MarcEngrie/BoilerController/Photos/IMG_20221119_143101.jpg

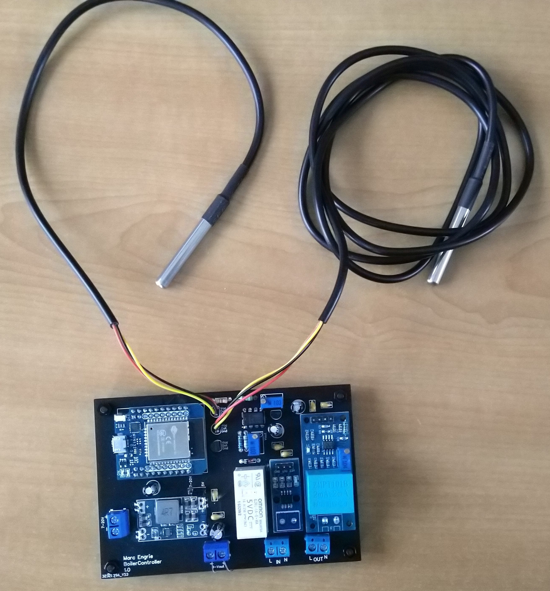
Photos/IMG_20221119_143101.jpg
