MarcEngrie/BoilerController/Photos/IMG_20221120_123733.jpg

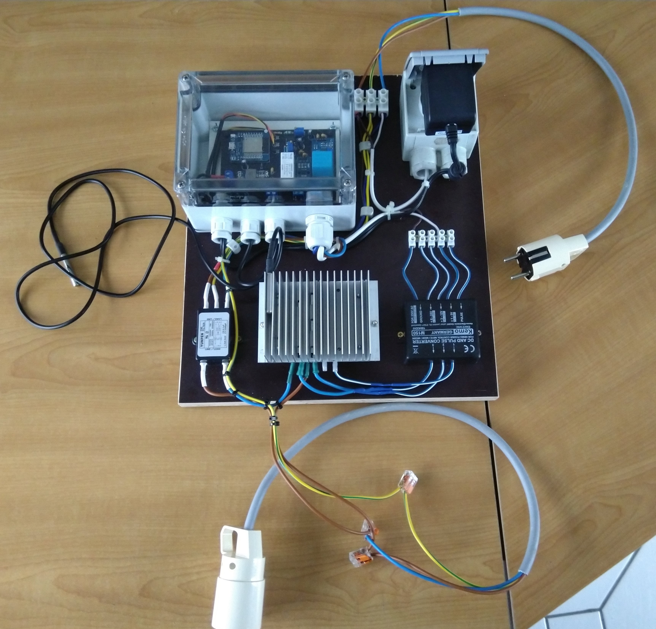
Photos/IMG_20221120_123733.jpg
