MarcEngrie/BoilerController/README.md

# BoilerController
Interface to a hot water boiler and a home automation system using MQTT
