MarcEngrie/BoilerController/EasyEDA/PCB_PCB_BoilerController_2022-11-26.png

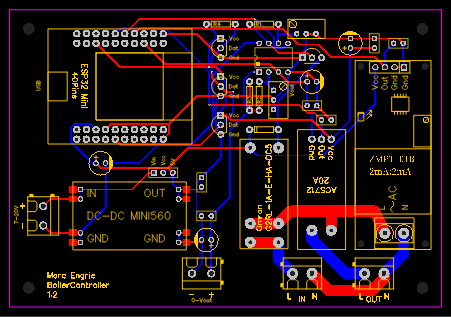
EasyEDA/PCB_PCB_BoilerController_2022-11-26.png
