MarcEngrie/BoilerController/EasyEDA/Schematic_BoilerController_2022-11-26.png

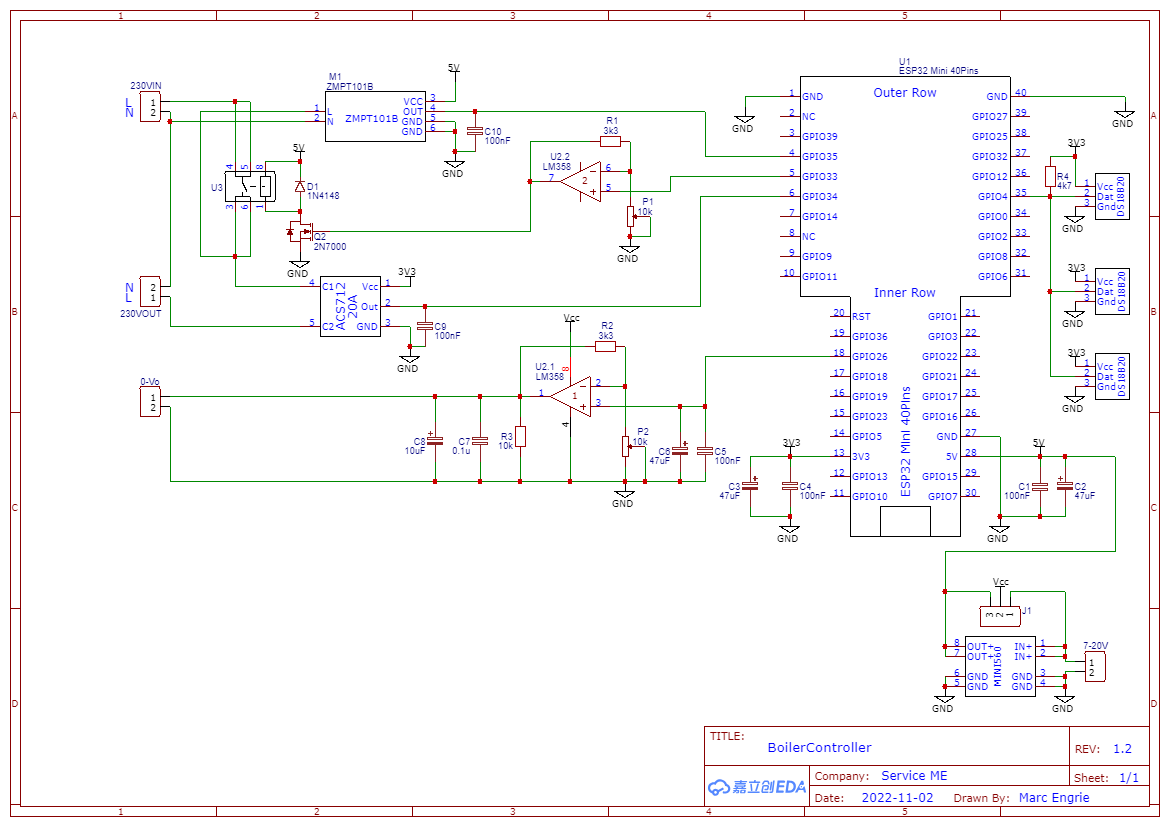
EasyEDA/Schematic_BoilerController_2022-11-26.png
