MarcEngrie/BoilerController/(list of files, drawings)

Other design files:
EasyEDA/BoilerController.json
EasyEDA/PCB_BoilerController.json
